BramptonnOnGithub/A24_ruler/PowerCouple/PowerCoupleRuler/C3I_A24_4_BOM.pdf

Reference | Qty | Value | Description | Footprint | LCSC Part # | Mft. Part # | Prix unitaire | Link
U8 | 1 MCP2210x-SS | USB to SPI Protocol Converter with GPIO, SSOP-20 | Package_SO:SSOP-20_5.3x7.2mm_P0.65mm MCP2210-I/SS-NDMCP2210-I/SS | 4.1000 $ | https://www.digikey.ca/en/products/detail/microchip-technology/MCP2210-I-SS/2835087
U9 | | 1 ATMEGA328PB-AU | IC MCU 8BIT 32KB FLASH 32TQFP | digikey-footprints:TQFP-32_7x7mm | C132230 | ATMEGA328PB-AU | 1.8787 $ | https://www.lcsc.com/product-detail/MICROCHIP_Microchip-Tech-ATMEGA328PB-AU_C132230.html
U10 | | 1 encoder | SMD,18x19.5mm Rotary Encoders ROHS | footprint:K1-5301UA-01 | C128931 | K1-5301UA-01 | 1.2831 $ | https://www.lcsc.com/product-detail/Rotary-Encoders_Korean-Hroparts-Elec-K1-5301UA-01_C128931.html
BT1 | | 1 CR123A | Multiple-cell battery | footprint:BH-123A-B5BA003 | C19184081 | BH-123A-B5BA003 | 0.7972 $ | https://www.lcsc.com/product-detail/Button-And-Strip-span-style-background-color-ff0-Battery-span-Connector_MYOUNG-BH-123A-B5BA003_C19184081.html
U2,U3,U4,U5,U6 | | 5 KCSA02-136 | One digit 7 segment red LED, common anode | footprint:GS2016AR-G | C22462635 | GS2016AR-G | 0.3920 $ | https://www.lcsc.com/product-detail/LED-Segment-Displays_Guangcai-Display-GS2016AR-G_C22462635.html
U7 | | 1 USB-A male | 1.5A 1 4P Male -40â„ƒ~+85â„ƒ Type-A SMD USB Connectors ROHS | footprint:USB-A-MALE-SMD | C397451 | U216-041N-1WS82-5 | 0.1263 $ | https://www.lcsc.com/product-detail/USB-Connectors_XKB-Connection-U216-041N-1WS82-5_C397451.html
SW3 | | 1 DPDT | Standing paste 1A DPDT 6V Black 10,000 times SMD Slide Switches ROHS | footprint:22D28 DPDT | C963205 | MS-22D28-G020 | 0.1168 $ | https://www.lcsc.com/product-detail/Slide-Switches_G-Switch-MS-22D28-G020_C963205.html
J1 | | 1 AVR-ISP-6 | Atmel 6-pin ISP connector | footprint:HARWIN_M20-8760342 | C780054 | X6521WVS-2x03H-C60D74 | 0.0858 $ | https://www.lcsc.com/product-detail/Pin-Headers_XKB-Connection-X6521WVS-2x03H-C60D74_C780054.html
J2 | | 1 SD_CARD_140-01-A | 2mm Card Slot MicroSD card (TF card) Self-bouncing SMD SD Card / Memory Card Connector ROHS | footprint:TF-SMD_TF-02 | C2889258 | TF-01A | 0.0800 $ | https://www.lcsc.com/product-detail/SD-Card-Connectors_Yuandi-TF-01A_C2889258.html
SW2 | | 1 SW_SPST | Single Pole Single Throw (SPST) switch | footprint:MST-22D18G2 3J | C668586 | MST-22D18G2 3J | 0.0767 $ | https://www.lcsc.com/product-detail/Slide-Switches_SHOU-HAN-MST-22D18G2-3J_C668586.html
U1 | 1 TM1652 | 5 x 8 segment driver | Package_SO:SOIC-16_3.9x9.9mm_P1.27mm C52186 | TM1652 | 0.0763 $ | https://www.lcsc.com/product-detail/Digital-Tube-Drivers_TM-Shenzhen-Titan-Micro-Elec-TM1652_C52186.html
D1 | 1 350mV@100mA shottky diode 30V 1A 350mV@100mA SOD-123 Schottky Diodes ROHS | Diode_SMD:D_SOD-123 | C917121 | NRVB130T1G | 0.0417 $ | https://www.lcsc.com/product-detail/Schottky-Diodes_JSMSEMI-NRVB130T1G_C917121.html
SW4,SW5,SW6,SW7,SW8,SW9 | 6 SW_TACTILE | Without 50mA 4mm 100MÎ© 100000 Times 12V 160gf 3mm 2mm Round Button Standing paste SPST SMD Tactile Switches ROHS footprint:TS-1088-AR02016 | C720477 | TS-1088-AR02016 | 0.0407 $ | https://www.lcsc.com/product-detail/Tactile-Switches_XUNPU-TS-1088-AR02016_C720477.html
F1 | | 1 800mA | 50A SMD Fuse 800mA 63V 1206 Disposable fuses ROHS | Fuse:Fuse_1206_3216Metric | C163134 | CFS12V6TR80 | 0.0350 $ | https://www.lcsc.com/product-detail/Disposable-fuses_TA-I-Tech-CFS12V6TR80_C163134.html
D2 | | 1 3.3V~3.5V 500mW | 3.3V~3.5V 500mW 3.3V SOD-123 Zener Diodes ROHS | Diode_SMD:D_SOD-123 | C2891770 | BZT52C3V3 | 0.0110 $ | https://www.lcsc.com/product-detail/Zener-Diodes_YONGYUTAI-BZT52C3V3_C2891770.html
C1 | | 1 10uF | Unpolarized capacitor | Capacitor_SMD:C_0805_2012Metric | C1713 | CL21A106KOQNNNE | 0.0079 $ | https://www.lcsc.com/product-detail/Multilayer-Ceramic-Capacitors-MLCC-SMD-SMT_Samsung-Electro-Mechanics-CL21A106KOQNNNE_C1713.html
Y1 | | 1 Crystal | Two pin crystal | footprint:HC-49S-SMD-2P-Mini | C2983429 | 16M 20PF 15PPM | 0.0057 $ | https://www.lcsc.com/product-detail/Crystals_SST-16M-20PF-15PPM_C2983429.html
C7,C8,C9,C10,C11,C12 | | 6 2.2uF | SMD 0603 MLCC capacitor, Alternate KiCad Library | Capacitor_SMD_AKL:C_0603_1608Metric | C22399622 | CGA0603X5R225K6R3JT | 0.0052 $ | https://www.lcsc.com/product-detail/Multilayer-Ceramic-Capacitors-MLCC-SMD-SMT_HRE-CGA0603X5R225K6R3JT_C22399622.html
C2,C3 | | 2 33pF | SMD 0603 MLCC capacitor, Alternate KiCad Library | Capacitor_SMD_AKL:C_0603_1608Metric | C363551 | FN18N330J500PSG | 0.0022 $ | https://www.lcsc.com/product-detail/Multilayer-Ceramic-Capacitors-MLCC-SMD-SMT_PSA-Prosperity-Dielectrics-FN18N330J500PSG_C363551.html
C15,C16 | | 2 0.1uF | SMD 0603 MLCC capacitor, Alternate KiCad Library | Capacitor_SMD_AKL:C_0603_1608Metric | C282519 | TCC0603X7R104K500CT | 0.0019 $ | https://www.lcsc.com/product-detail/Multilayer-Ceramic-Capacitors-MLCC-SMD-SMT_CCTC-TCC0603X7R104K500CT_C282519.html
R18,R19,R20,R21,R22,R23,R24,R25,R26,R27,R28,R29,R30 | 13 4.99k | 100mW Thick Film Resistors 75V Â±100ppm/â„ƒ Â±1% 4.99kÎ© 0603 Chip Resistor - Surface Mount ROHS | PCM_Resistor_SMD_AKL:R_0603_1608MetricC2933228 | FRC0603F4991TS | 0.0009 $ | https://www.lcsc.com/product-detail/Chip-Resistor-Surface-Mount_FOJAN-FRC0603F4991TS_C2933228.html
R12,R13,R16,R17 | | 4 1K | SMD 0603 Chip Resistor, US Symbol, Alternate KiCad Library | Resistor_SMD_AKL:R_0603_1608Metric | C103209 | RTT03102JTP | 0.0008 $ | https://www.lcsc.com/product-detail/Chip-Resistor-Surface-Mount_RALEC-RTT03102JTP_C103209.html
R9,R10 | 2 | 0 SMD 0603 Chip Resistor, US Symbol, Alternate KiCad Library | Resistor_SMD_AKL:R_0603_1608Metric | C3017805 | SCR0603J0R | 0.0008 $ | https://www.lcsc.com/product-detail/Chip-Resistor-Surface-Mount_VO-SCR0603J0R_C3017805.html
R1,R2,R3,R4,R5,R6,R7,R8 | 8 | 71.5 100mW Thick Film Resistors 75V Â±100ppm/â„ƒ Â±1% 71.5Î© 0603 Chip Resistor - Surface Mount ROHS | Resistor_SMD:R_0402_1005Metric | C2933255 | FRC0603F71R5TS | 0.0008 $ | https://www.lcsc.com/product-detail/Chip-span-style-background-color-ff0-Resistor-span-Surface-Mount_FOJAN-FRC0603F71R5TS_C2933255.html
R11,R38,R39,R40 | | 4 10k | 100mW Thick Film Resistors 75V Â±100ppm/â„ƒ Â±5% 10kÎ© 0603 Chip Resistor - Surface Mount ROHS | Resistor_SMD_AKL:R_0603_1608Metric | C2930027 | FRC0603J103TS | 0.0007 $ | https://www.lcsc.com/product-detail/Chip-Resistor-Surface-Mount_FOJAN-FRC0603J103TS_C2930027.html
Coût total : | 10.99 $
