BramptonnOnGithub/A24_ruler/PowerCouple/PowerCoupleRuler/C3I_A24_4_SchemaElec.pdf

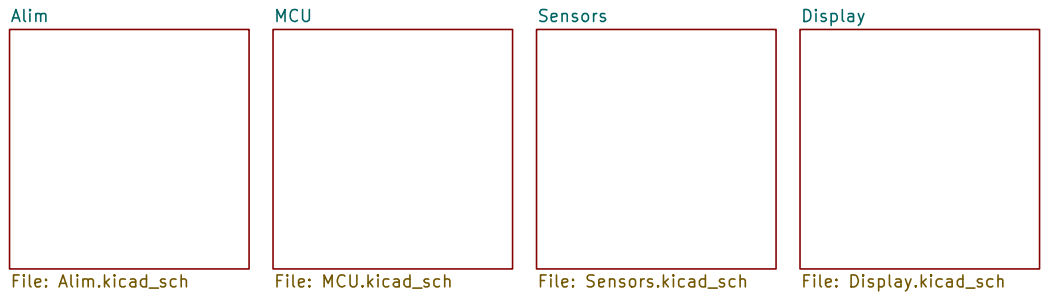
[picture p11: page 1]

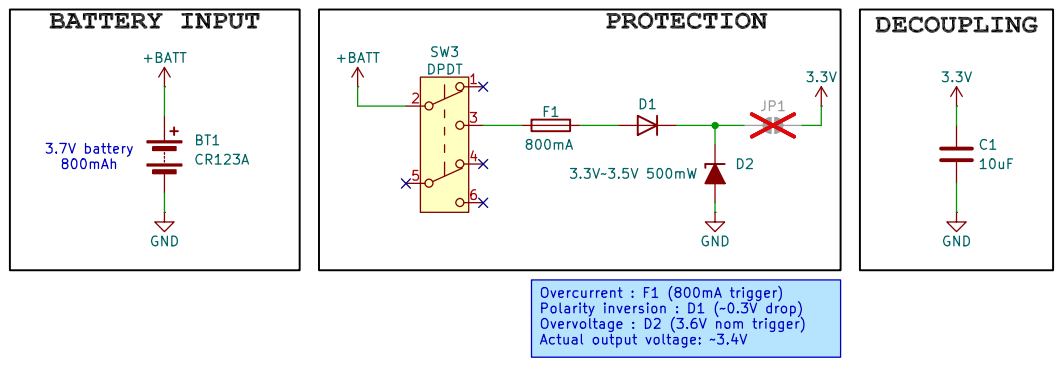
[picture p12: page 2]

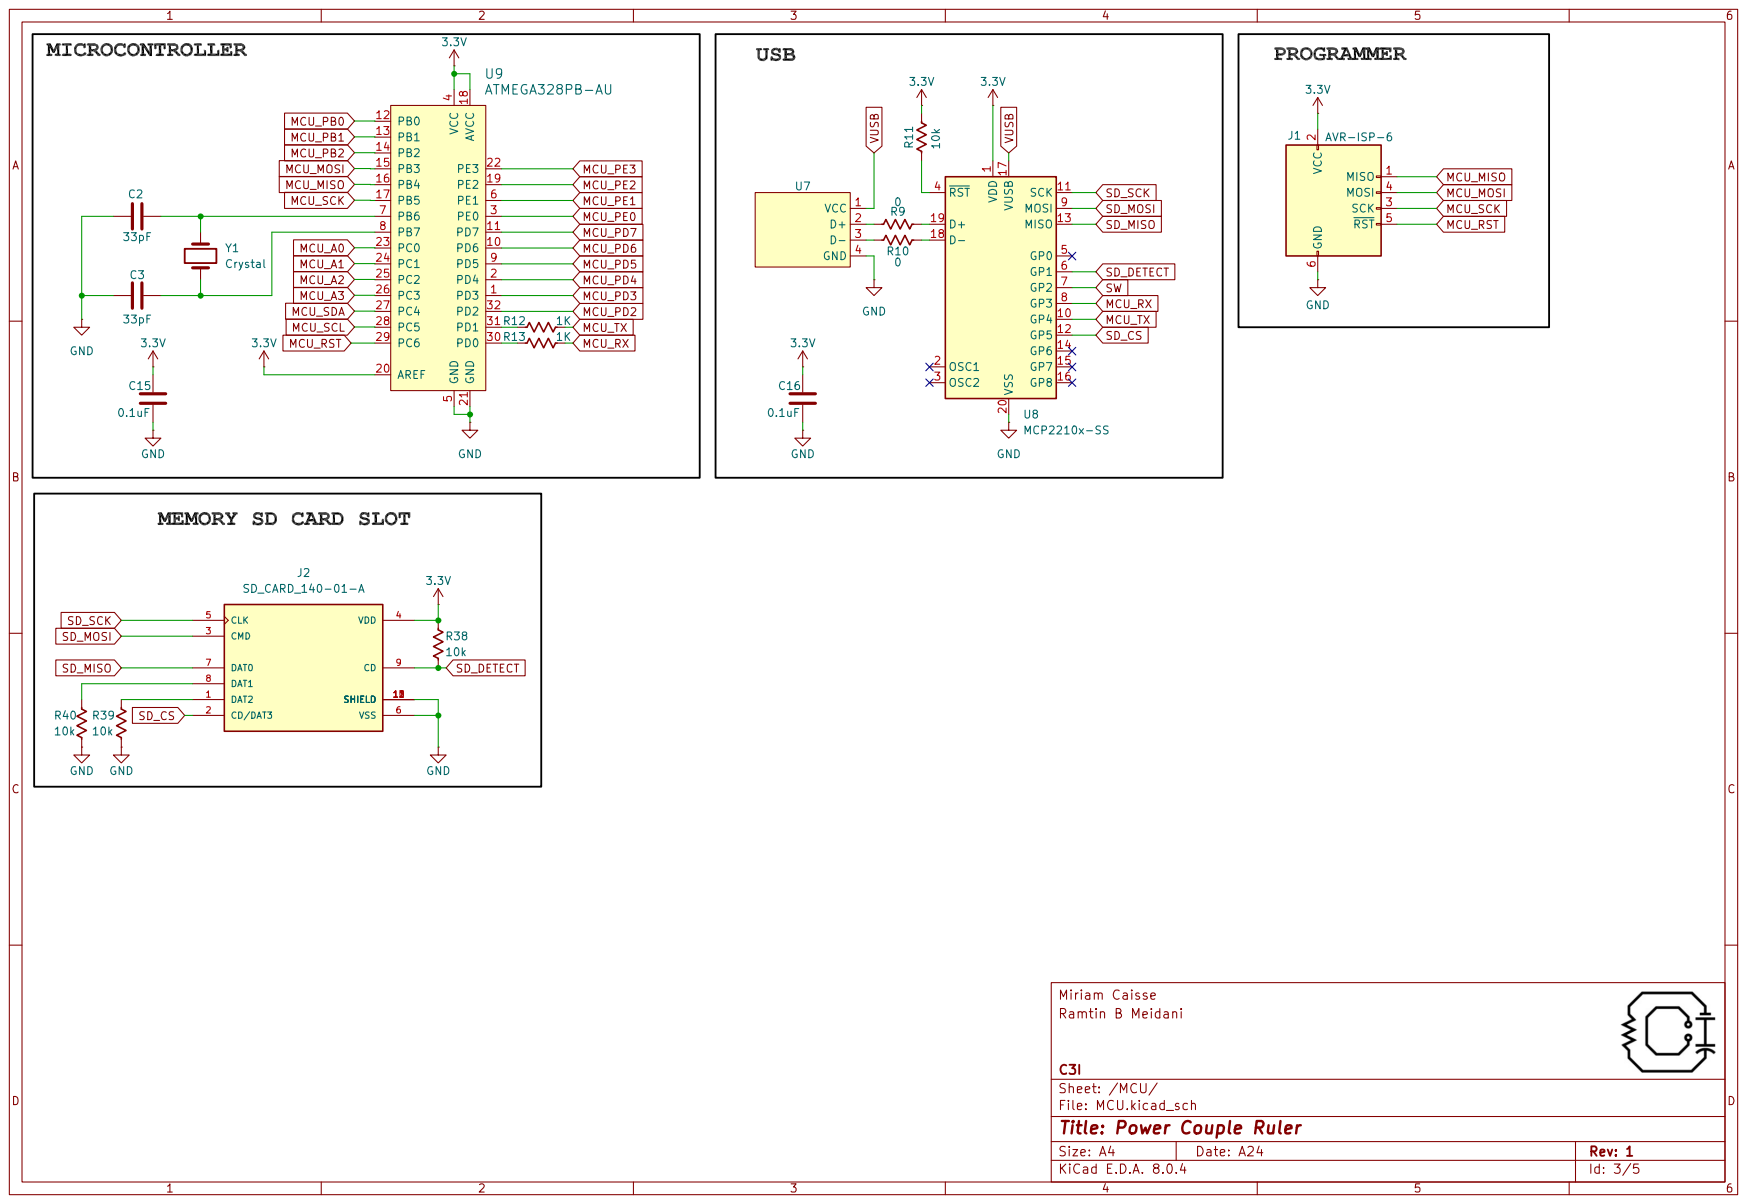
[picture p13: page 3]

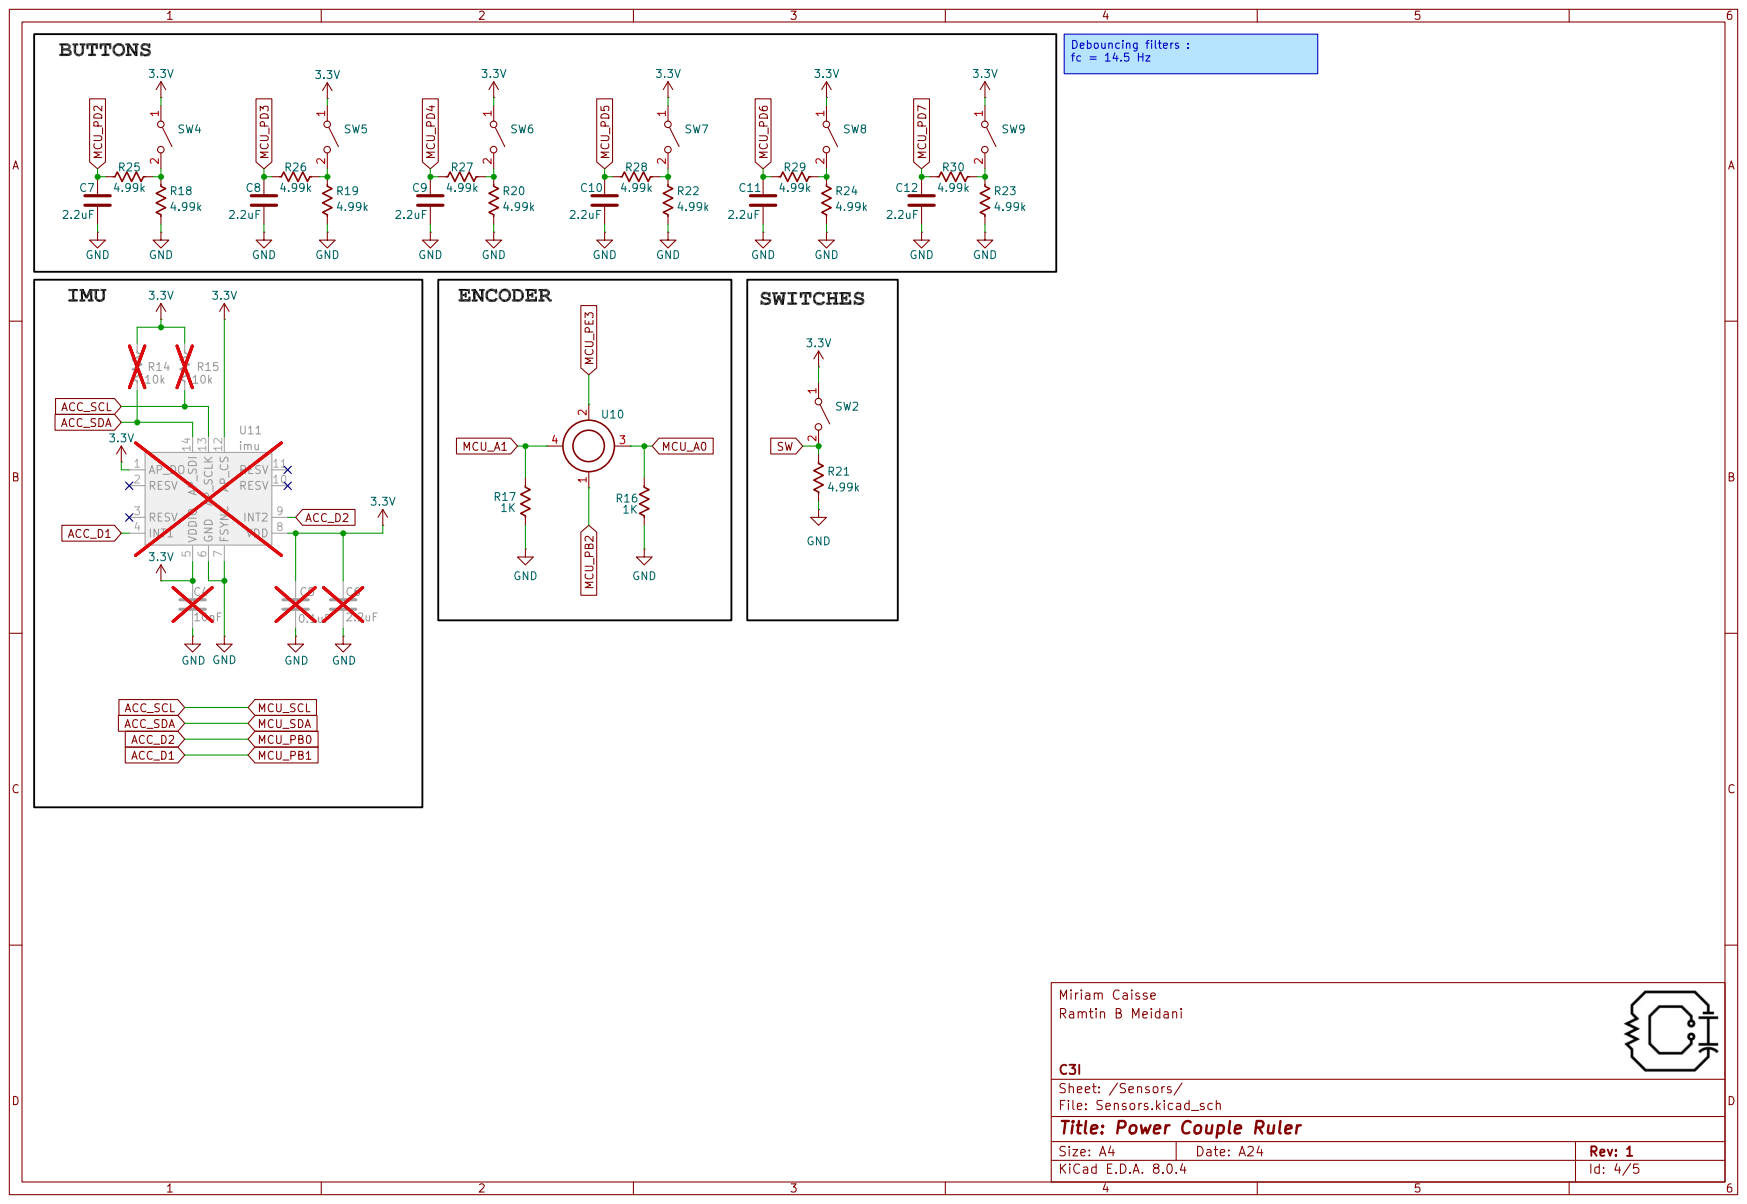
[picture p14: page 4]

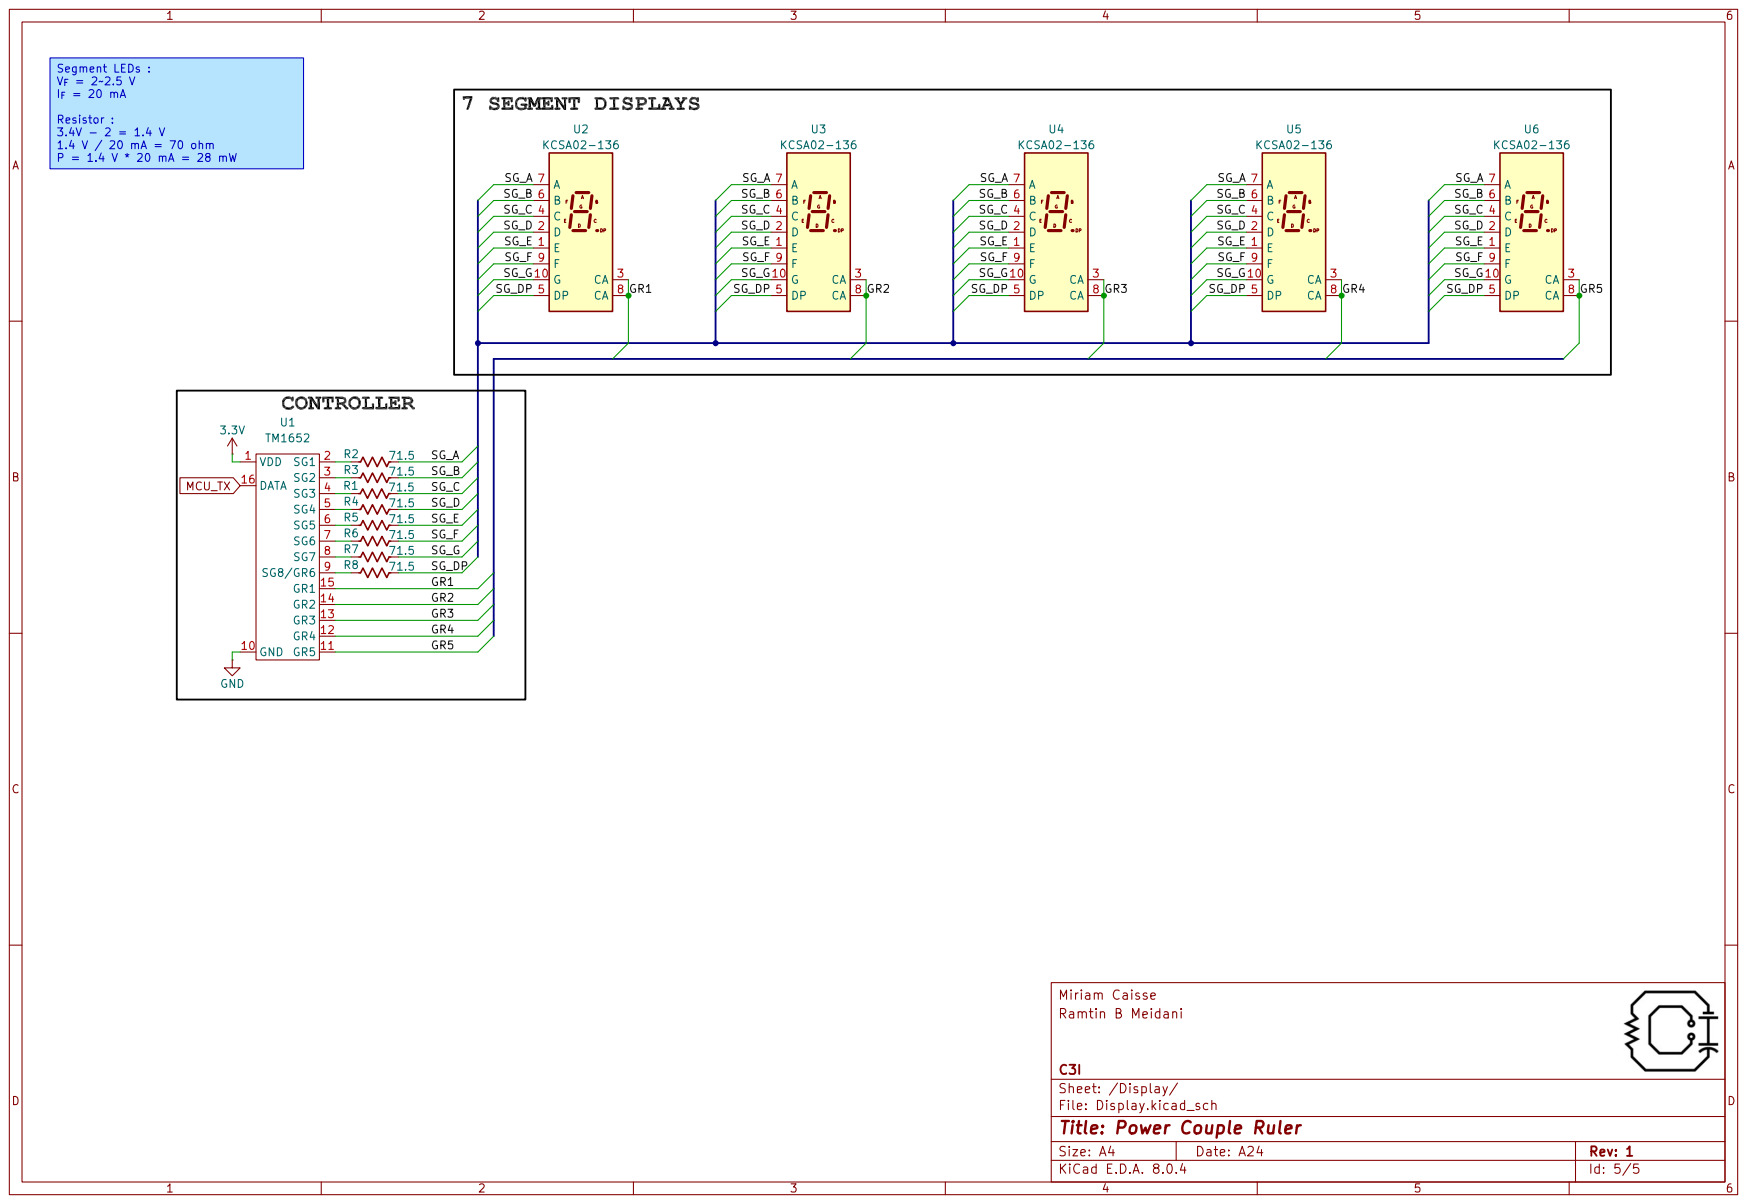
[picture p15: page 5]
