BramptonnOnGithub/A24_ruler/PowerCouple/PowerCoupleRuler/PowerCoupleRuler/UART.h

/*
 * UART.h
 * Author: Miriam C
 */ 

#include "include_generic.h"

void UARTInit();

void USART0_SendBytes(uint8_t *data, uint8_t length);

void transmitByte(uint8_t data);

uint8_t receiveByte(void);
