BramptonnOnGithub/A24_ruler/PowerCouple/PowerCoupleRuler/PowerCoupleRuler/Buttons.h

/*
 * Buttons.h
 * Author: Miriam C
 */ 

#include "include_generic.h"

void buttonInit();

//Button actions
void buttonReduce();
void buttonIncrement();
void buttonAddSub();
void buttonCalib();
void buttonReset();
void buttonSave();
