BramptonnOnGithub/A24_ruler/(commit log)

2024-12-27 Button setups
2024-12-27 encoder merge
2024-12-28 Documentation et remise :)
    hahaha coffee make brain go brr
    [C3I_A24_4_BOM.xlsx]
2024-12-28 KiCad et gerber
    man i sure hope it kept the folder but im a tad too tired to care
    [Ruler_PowerCouple-B_Cu.gbr, Ruler_PowerCouple-B_Mask.gbr, Ruler_PowerCouple-B_Silks.gbr, Ruler_PowerCouple-Edge_Cuts.gbr, Ruler_PowerCouple-F_Cu.gbr, Ruler_PowerCouple-F_Mask.gbr, Ruler_PowerCouple-F_Silks.gbr, Ruler_PowerCouple-NPTH.drl]
